spbnick/bc/bc.kicad/bc.kicad_pcb

## KiCad design bc.kicad/bc.kicad_pcb (2021-01-09)

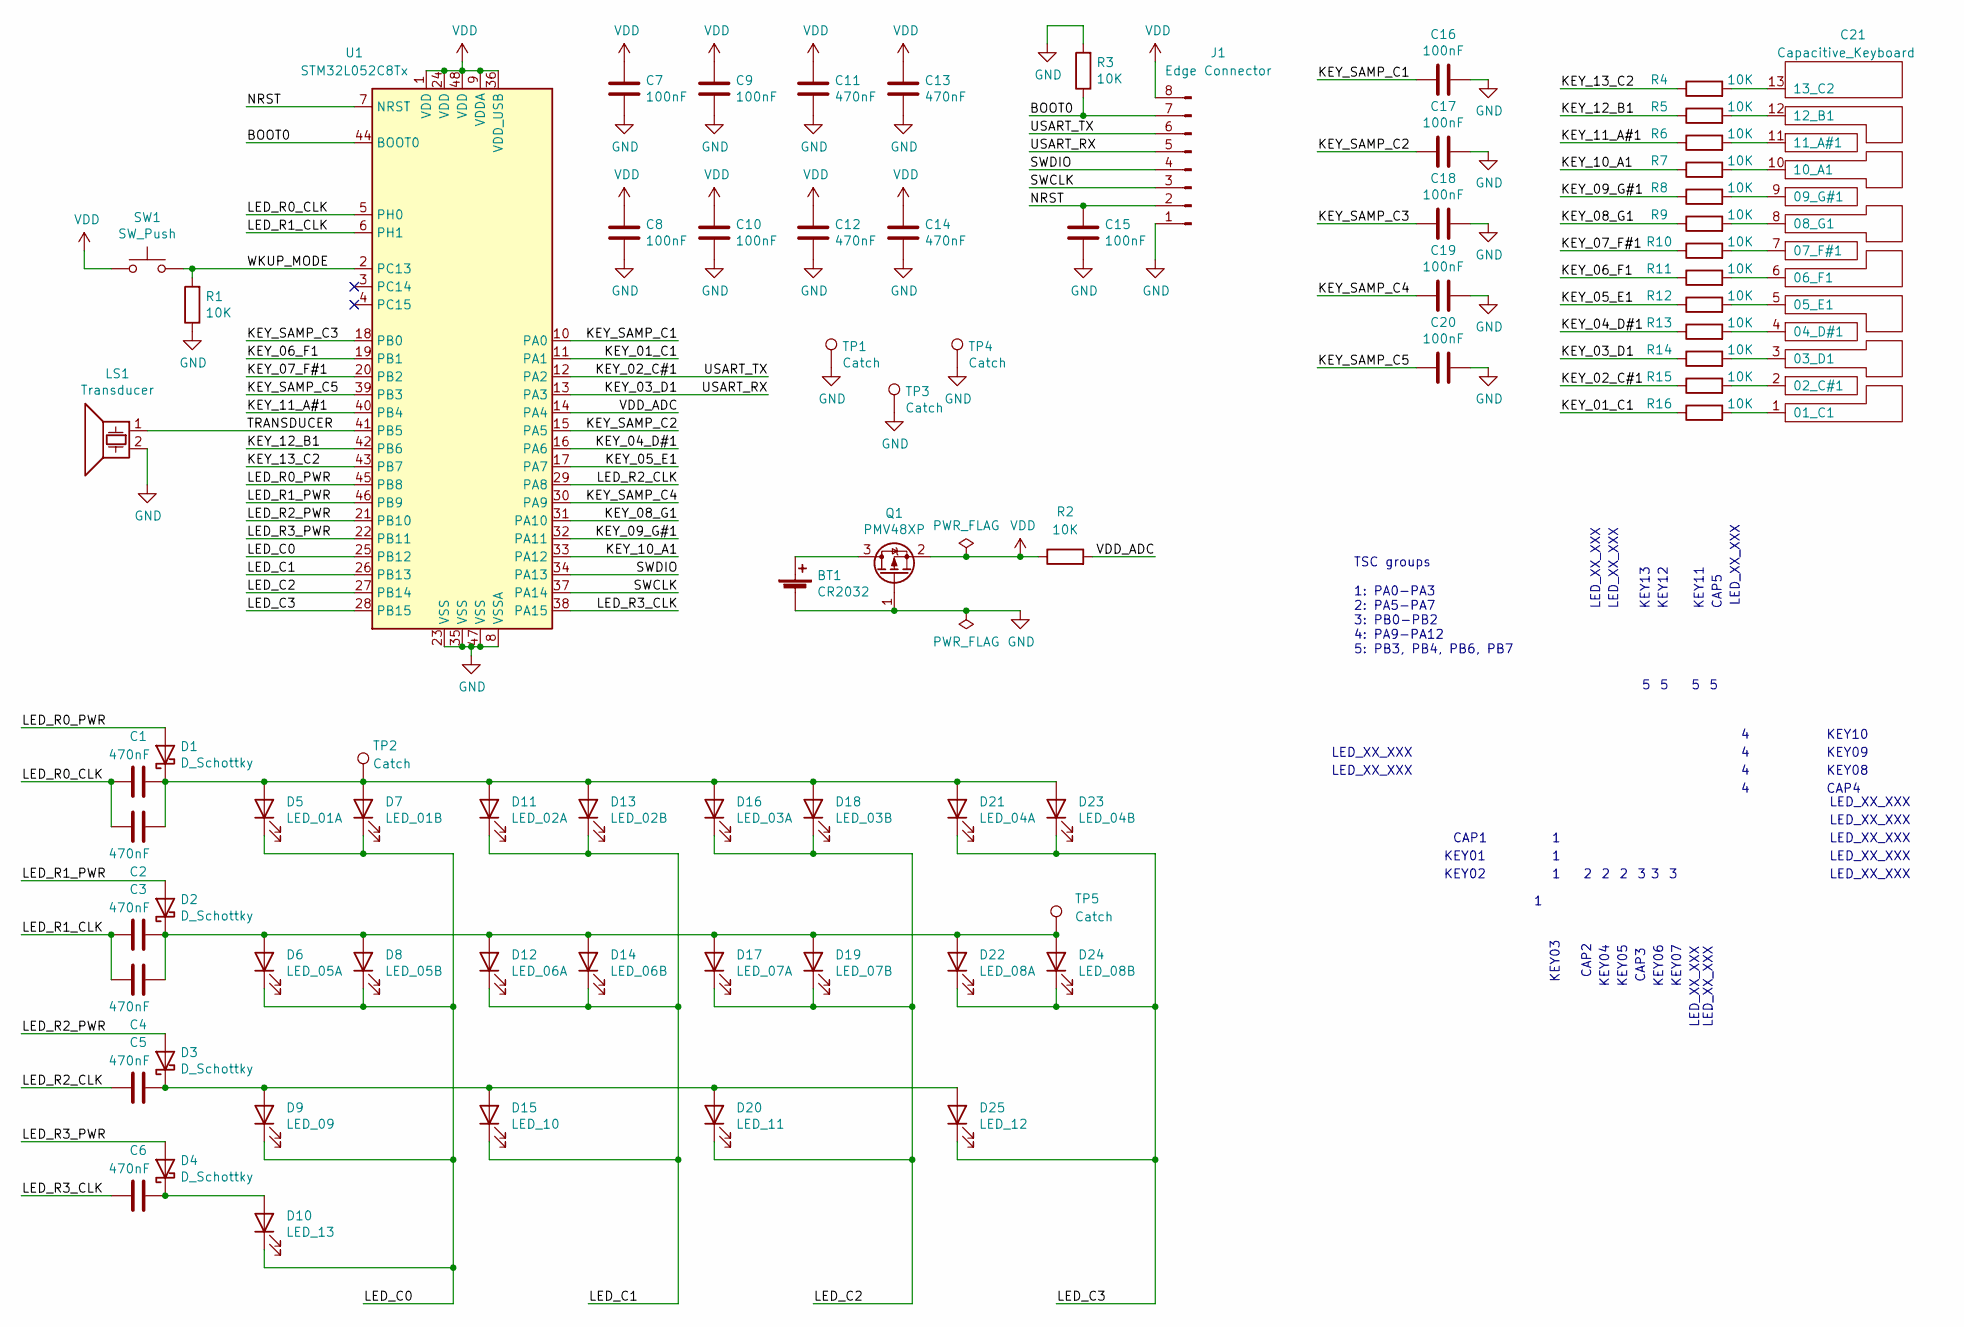
[picture p1: schematic bc.sch]

Parts:
BT1: CR2032; BatteryHolder_Keystone_3002_1x2032; LCSC C238099
C1, C2, C3, C4, C5, C6, C11, C12, C13, C14: 470nF; C_0402_1005Metric; LCSC C47339
C7, C8, C9, C10, C15, C16, C17, C18, C19, C20: 100nF; C_0402_1005Metric; LCSC C1525
C21: Capacitive_Keyboard; keyboard
D1, D2, D3, D4: D_Schottky; D_SOD-123; LCSC C8598
D5: LED_01A; side_led; Digi-Key 160-1870-1-ND
D6: LED_05A; side_led
D7: LED_01B; side_led
D8: LED_05B; side_led
D9: LED_09; side_led
D10: LED_13; side_led
D11: LED_02A; side_led
D12: LED_06A; side_led
D13: LED_02B; side_led
D14: LED_06B; side_led
D15: LED_10; side_led
D16: LED_03A; side_led
D17: LED_07A; side_led
D18: LED_03B; side_led
D19: LED_07B; side_led
D20: LED_11; side_led
D21: LED_04A; side_led
D22: LED_08A; side_led
D23: LED_04B; side_led
D24: LED_08B; side_led
D25: LED_12; side_led
J1: Edge Connector; edge_connector
LS1: Transducer; transducer; Digi-Key 668-1538-1-ND
Q1: PMV48XP; SOT-23; LCSC C75560
R1, R2, R3, R4, R5, R6, R7, R8, R9, R10, R11, R12, R13, R14, R15, R16: 10K; R_0402_1005Metric; LCSC C25744
SW1: SW_Push; SW_Push_1P1T_NO_5.1x5.1mm_H2.5mm; LCSC C318889
TP1, TP2, TP3, TP4, TP5: Catch; test_point; LCSC C238131
U1: STM32L052C8Tx; LQFP-48_7x7mm_P0.5mm; LCSC C111213

Connections:
/BOOT0: J1.7, R3.1, U1.44 (BOOT0)
/KEY_01_C1: R16.1, U1.11 (PA1)
/KEY_02_C#1: J1.6, R15.1, U1.12 (PA2)
/KEY_03_D1: J1.5, R14.1, U1.13 (PA3)
/KEY_04_D#1: R13.1, U1.16 (PA6)
/KEY_05_E1: R12.1, U1.17 (PA7)
/KEY_06_F1: R11.1, U1.19 (PB1)
/KEY_07_F#1: R10.1, U1.20 (PB2)
/KEY_08_G1: R9.1, U1.31 (PA10)
/KEY_09_G#1: R8.1, U1.32 (PA11)
/KEY_10_A1: R7.1, U1.33 (PA12)
/KEY_11_A#1: R6.1, U1.40 (PB4)
/KEY_12_B1: R5.1, U1.42 (PB6)
/KEY_13_C2: R4.1, U1.43 (PB7)
/KEY_SAMP_C1: C16.2, U1.10 (PA0)
/KEY_SAMP_C2: C17.2, U1.15 (PA5)
/KEY_SAMP_C3: C18.2, U1.18 (PB0)
/KEY_SAMP_C4: C19.2, U1.30 (PA9)
/KEY_SAMP_C5: C20.2, U1.39 (PB3)
/LED_C0: D5.1 (K), D6.1 (K), D7.1 (K), D8.1 (K), D9.1 (K), D10.1 (K), U1.25 (PB12)
/LED_C1: D11.1 (K), D12.1 (K), D13.1 (K), D14.1 (K), D15.1 (K), U1.26 (PB13)
/LED_C2: D16.1 (K), D17.1 (K), D18.1 (K), D19.1 (K), D20.1 (K), U1.27 (PB14)
/LED_C3: D21.1 (K), D22.1 (K), D23.1 (K), D24.1 (K), D25.1 (K), U1.28 (PB15)
/LED_R0_CLK: C1.1, C2.1, U1.5 (PH0)
/LED_R0_PWR: D1.2 (A), U1.45 (PB8)
/LED_R1_CLK: C3.1, C4.1, U1.6 (PH1)
/LED_R1_PWR: D2.2 (A), U1.46 (PB9)
/LED_R2_CLK: C5.1, U1.29 (PA8)
/LED_R2_PWR: D3.2 (A), U1.21 (PB10)
/LED_R3_CLK: C6.1, U1.38 (PA15)
/LED_R3_PWR: D4.2 (A), U1.22 (PB11)
/NRST: C15.1, J1.2, U1.7 (NRST)
/SWCLK: J1.3, U1.37 (PA14)
/SWDIO: J1.4, U1.34 (PA13)
/TRANSDUCER: LS1.1, U1.41 (PB5)
/VDD_ADC: R2.2, U1.14 (PA4)
/WKUP_MODE: R1.2, SW1.2, U1.2 (PC13)
GND: BT1.2 (-), C7.2, C8.2, C9.2, C10.2, C11.2, C12.2, C13.2, C14.2, C15.2, C16.1, C17.1, C18.1, C19.1, C20.1, J1.1, LS1.2, Q1.1 (G), R1.1, R3.2, TP1.1, TP3.1, TP4.1, U1.8 (VSSA), U1.23 (VSS), U1.35 (VSS), U1.47 (VSS)
unnamed: BT1.1 (+), Q1.3 (D)
unnamed: C1.2, C2.2, D1.1 (K), D5.2 (A), D7.2 (A), D11.2 (A), D13.2 (A), D16.2 (A), D18.2 (A), D21.2 (A), D23.2 (A), TP2.1
unnamed: C3.2, C4.2, D2.1 (K), D6.2 (A), D8.2 (A), D12.2 (A), D14.2 (A), D17.2 (A), D19.2 (A), D22.2 (A), D24.2 (A), TP5.1
unnamed: C5.2, D3.1 (K), D9.2 (A), D15.2 (A), D20.2 (A), D25.2 (A)
unnamed: C6.2, D4.1 (K), D10.2 (A)
unnamed: C21.1 (01_C1), R16.2
unnamed: C21.2 (02_C#1), R15.2
unnamed: C21.3 (03_D1), R14.2
unnamed: C21.4 (04_D#1), R13.2
unnamed: C21.5 (05_E1), R12.2
unnamed: C21.6 (06_F1), R11.2
unnamed: C21.7 (07_F#1), R10.2
unnamed: C21.8 (08_G1), R9.2
unnamed: C21.9 (09_G#1), R8.2
unnamed: C21.10 (10_A1), R7.2
unnamed: C21.11 (11_A#1), R6.2
unnamed: C21.12 (12_B1), R5.2
unnamed: C21.13 (13_C2), R4.2
VDD: C7.1, C8.1, C9.1, C10.1, C11.1, C12.1, C13.1, C14.1, J1.8, Q1.2 (S), R2.1, SW1.1, U1.1 (VDD), U1.9 (VDDA), U1.24 (VDD), U1.36 (VDD_USB), U1.48 (VDD)

Notes on the sheet:
KEY01
KEY02
KEY03
KEY04
KEY05
KEY06
KEY07
KEY08
KEY09
KEY10
KEY11
KEY12
KEY13
TSC groups 1: PA0-PA3 2: PA5-PA7 3: PB0-PB2 4: PA9-PA12 5: PB3, PB4, PB6, PB7
CAP1
CAP2
CAP3
CAP4
CAP5
LED_XX_XXX

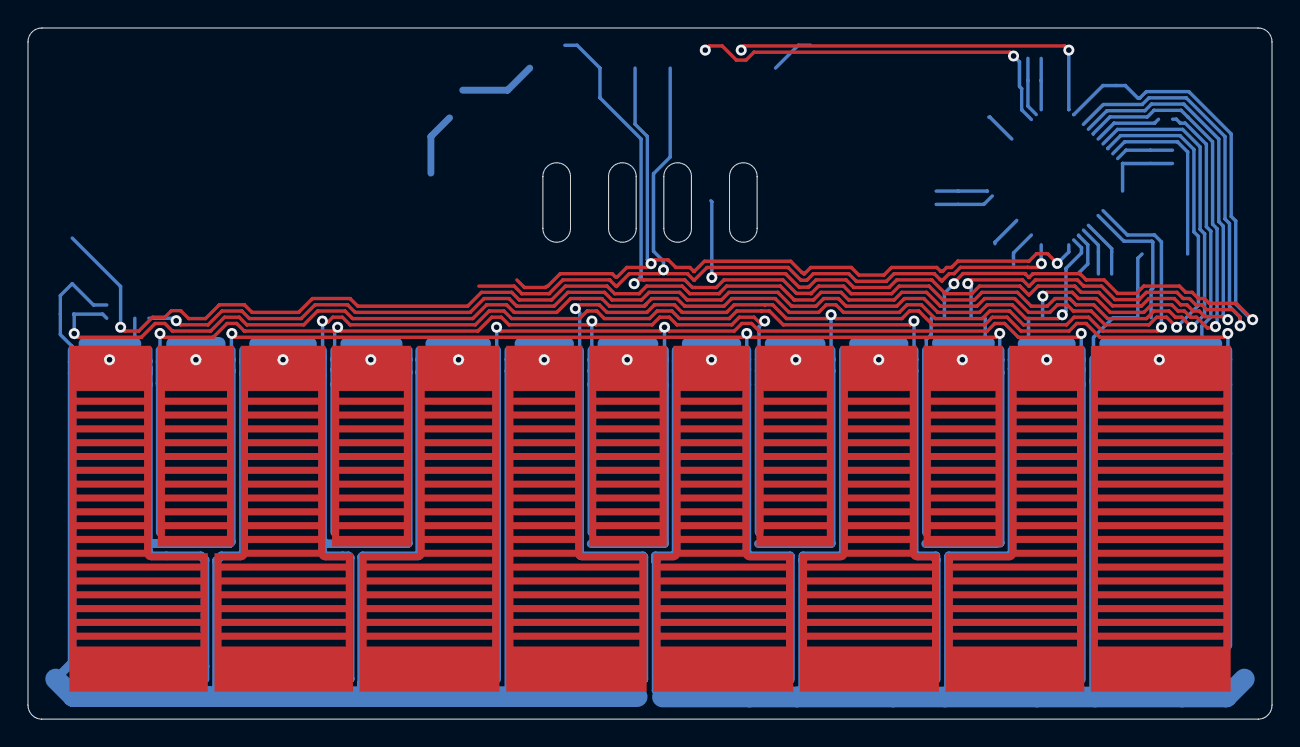
[picture p2: board bc.kicad_pcb from above]

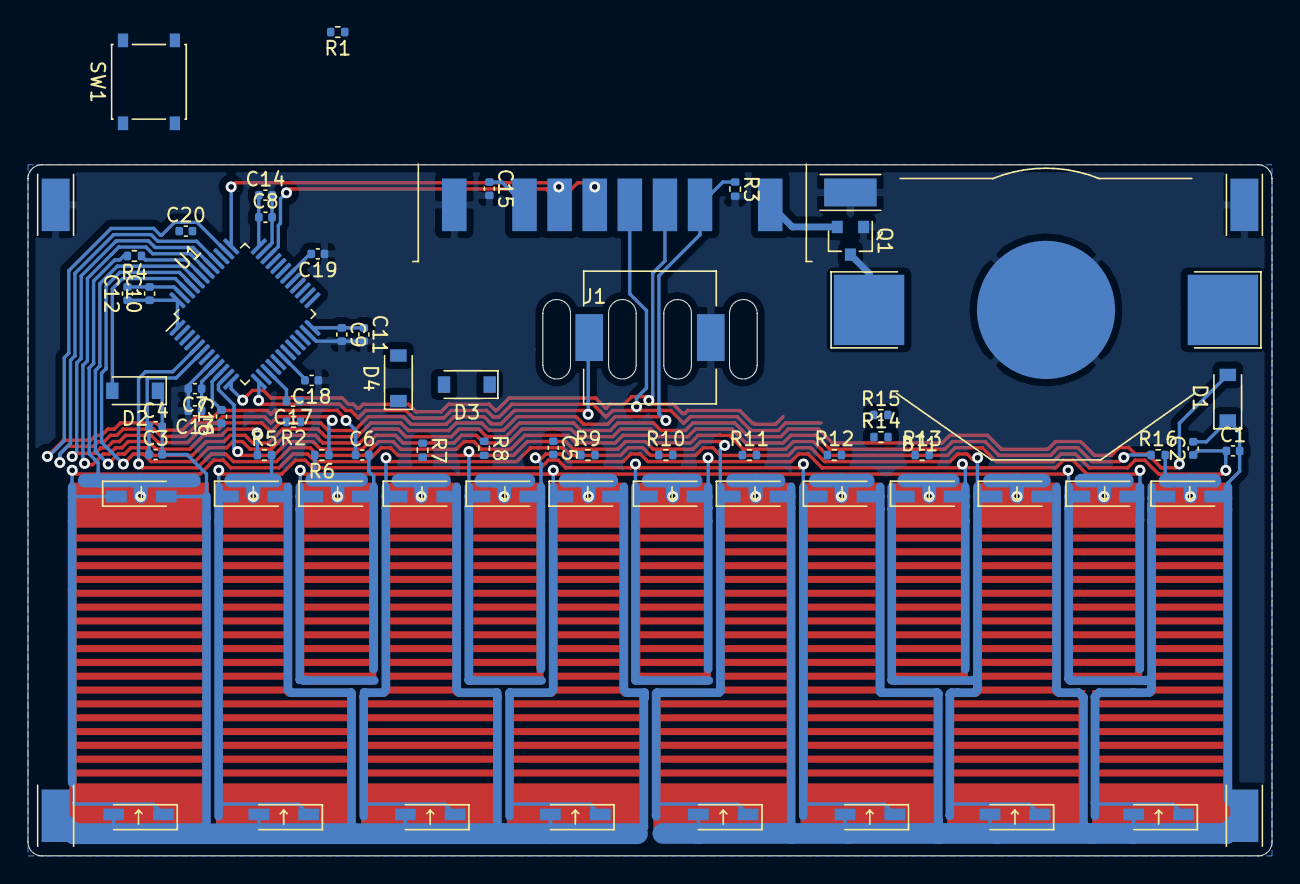
[picture p3: board bc.kicad_pcb from below]

Board: 2 copper layers, 90.0 x 50.0 mm, 73 parts (72 on the bottom side), 57 nets.
