spbnick/bc/(commit log)

2020-10-25 Add roughly laid-out PoC PCB
    [bc.kicad_pcb, bc.sch]
2020-12-04 Experiment with keyboard backlighting
    [3d_printed_light_guide_test.FCStd, 3d_printed_light_guide_test2.FCStd, bc.kicad_pcb, bc.sch, hot_glue_light_guide_test.FCStd, mold_test.FCStd]
2020-12-04 Remove first PoC design files
    [3d_printed_light_guide_test.FCStd, 3d_printed_light_guide_test2.FCStd, hot_glue_light_guide_test.FCStd, mold_test.FCStd]
2020-12-04 Switch from CR2016 to CR2032
    [bc.sch]
2020-12-19 Verify touch sensing design
    [bc.sch]
2020-12-21 Remove commented-out prototype code
2020-12-22 Validate LED control circuit
    [bc.sch]
2020-12-24 Connect VDD to ADC
    [bc.sch]
2020-12-24 Add bypassing to compensate for LED boosters
    [bc.sch]
2020-12-26 Define some parts and footprints
    [bc.sch]
2020-12-27 Assign all parts/footprints except keyboard
    [bc.sch]
2020-12-28 Layout keyboard half draft
    [bc.kicad_pcb, bc.sch]
2021-01-05 Block as much light as possible between keys
    [bc.kicad_pcb, bc.sch]
2021-01-09 Attempt pasta plate routing on the front
    [bc.kicad_pcb, bc.sch]
